ksasao/grove-qwiic-adapter/README.md

# grove-qwiic-adapter

M5Stack の Grove（HY2.0-4P の PORT.A、I²C）と Qwiic の I²C 機器をつなぐ変換基板です。

サポートページ: https://ksasao.github.io/grove-qwiic-adapter/
