ksasao/grove-qwiic-adapter/(commit log)

2026-11-10 サポートページを追加
    GitHub Pages（docs/）用に、スイッチサイエンス委託販売向けのサポートページを作成。
    仕様、ピン配置、つなぎかた、注意事項、回路図、お問い合わせフォームへのリンクを掲載。
2026-11-10 仕様表に基板の高さを追記
2026-11-10 メイン画像を 1000×1000px の正方形に変更
2026-11-10 Grove ポートに M5Stack の表記（HY2.0-4P / PORT.A）を併記
2026-11-12 docs: 商品名を「M5Stack用 Grove - Qwiic 変換アダプタ」にし、公式製品ではない旨を追記
2026-11-12 docs: Grove ケーブルの色を M5Stack 付属品と Seeed 品に分けて説明し、DFRobot の表記をそろえる
2026-11-12 docs: お問い合わせフォームのリンクを短縮 URL（ksasao.github.io/p/contact）にする
2026-11-13 tools: 出荷前検査のスケッチ (M5Atom Lite、adapter-test) を追加
2026-11-13 tools: 検査を 1 回目を捨てて 3 回調べる形にし、ロットごとの記録 (log.py) を追加
    - 挿した直後は Modulino Buzzer の起動が間に合わず不合格になるので、1 回目を捨てて、
    続けて 3 回すべて合格なら合格にする
    - log.py: Atom Lite の結果を、ロット番号 (p + 製品の番号 + YYMMDD) を付けて CSV に記録する
    - 検査の記録 (inspection/) は Git に入れない
    [adapter-test.ino, log.py]
2026-11-13 docs(adapter-test): 判定時間と RESULT の例を、1 回目を捨てて 3 回調べる今の検査に合わせる
2026-11-13 docs: 内容物（変換基板とピンヘッダ）の写真を追加
2026-11-13 docs: 写真の EXIF（撮影場所の位置情報など）を削除
    画像のデータはそのままで、メタデータだけを取り除いた。
